hankedan000/EThrottle/doc/board_layout/README.md

# v1.0
PCB_v1.0

### Enclosure interference
version 1.0 of the board had an interference issue with the DIYPNP aluminum enclosure. I was able to grind the case to make it fit, but the issue was resolved on v1.1 by reducing the width by 1.1mm.

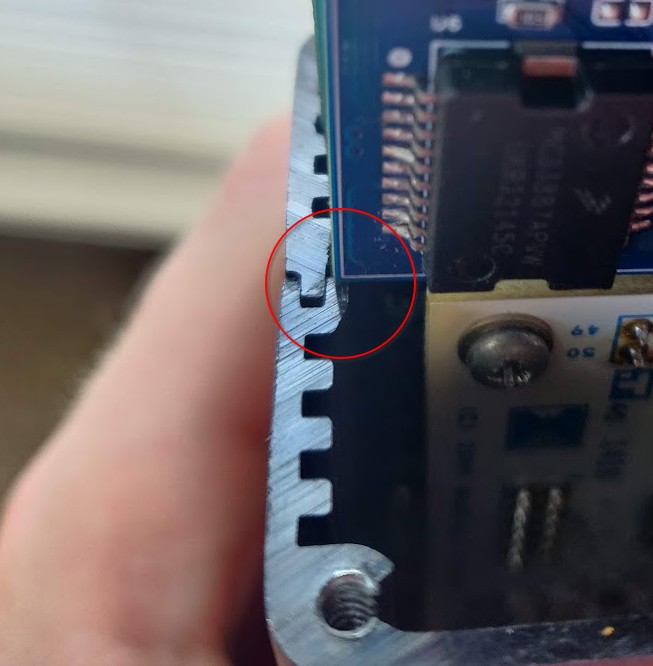
[picture p3: doc/board_layout/pcb_v1.0_case_interference.jpg]
v1.0_interference


# v1.1 (current)
NOT FINAL YET
