hankedan000/EThrottle/doc/board_layout/IMG_20220921_183644.jpg

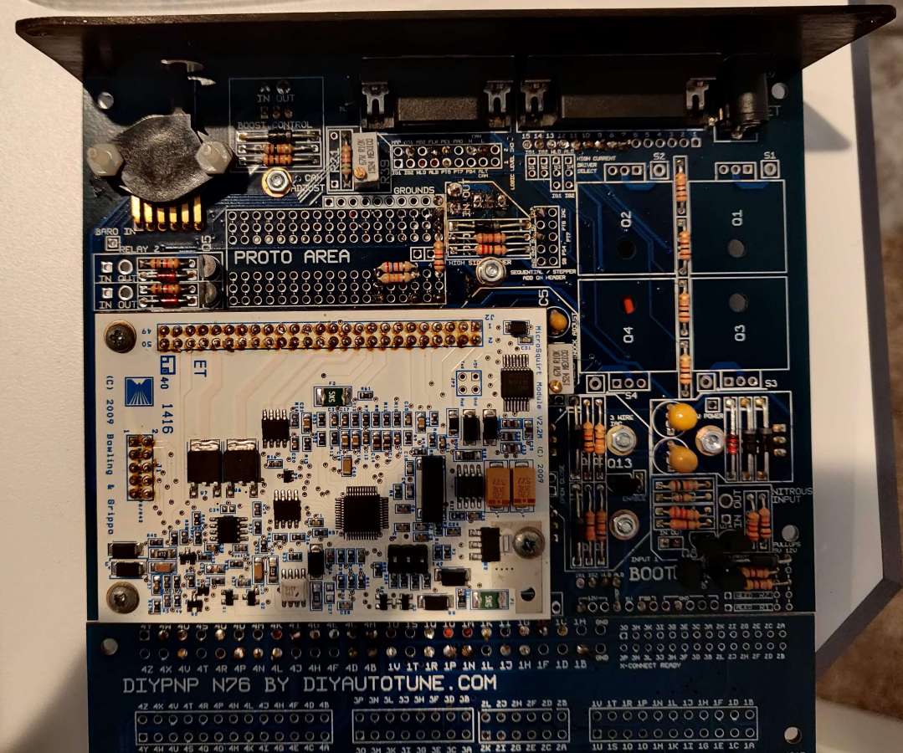
doc/board_layout/IMG_20220921_183644.jpg
