hankedan000/EThrottle/doc/wheel_speed/abs_circuit.png

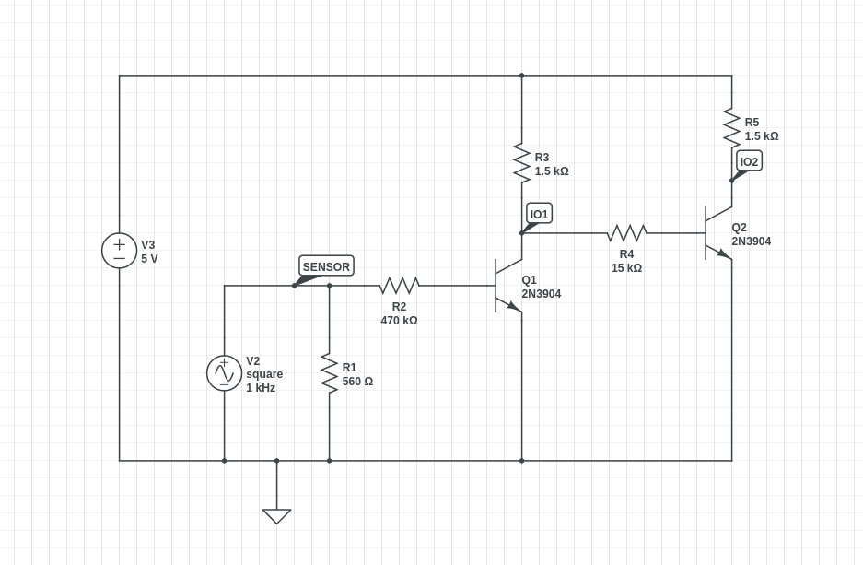
doc/wheel_speed/abs_circuit.png
