hankedan000/EThrottle/doc/wheel_speed/abs_circuit_td_sim.png

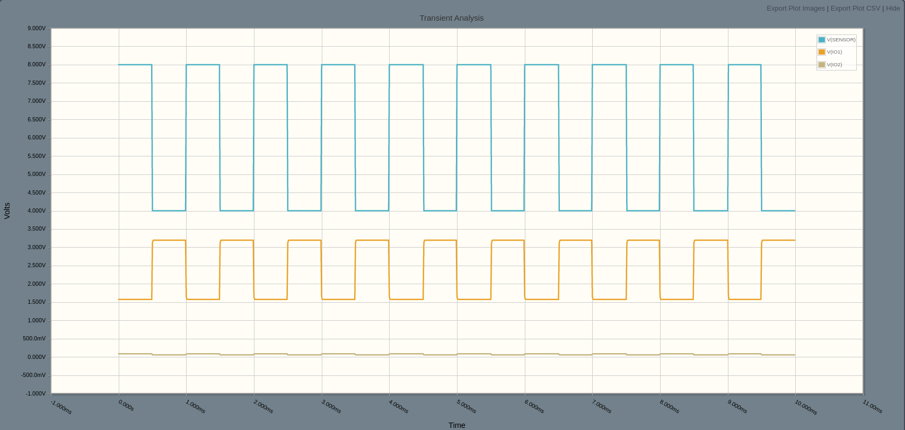
doc/wheel_speed/abs_circuit_td_sim.png
