hankedan000/EThrottle/doc/wheel_speed/abs_desktop_single_transistor.png

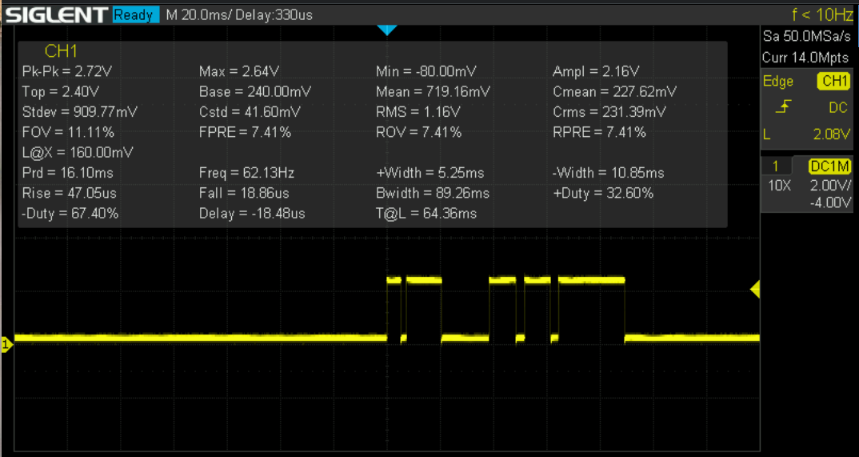
doc/wheel_speed/abs_desktop_single_transistor.png
