hankedan000/EThrottle/doc/wheel_speed/CAR_IO1.png

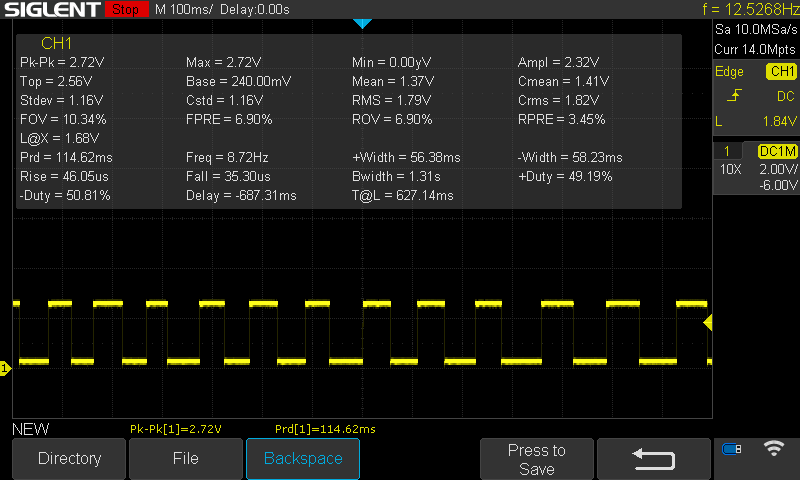
doc/wheel_speed/CAR_IO1.png
