hankedan000/EThrottle/doc/wheel_speed/CAR_IO2.png

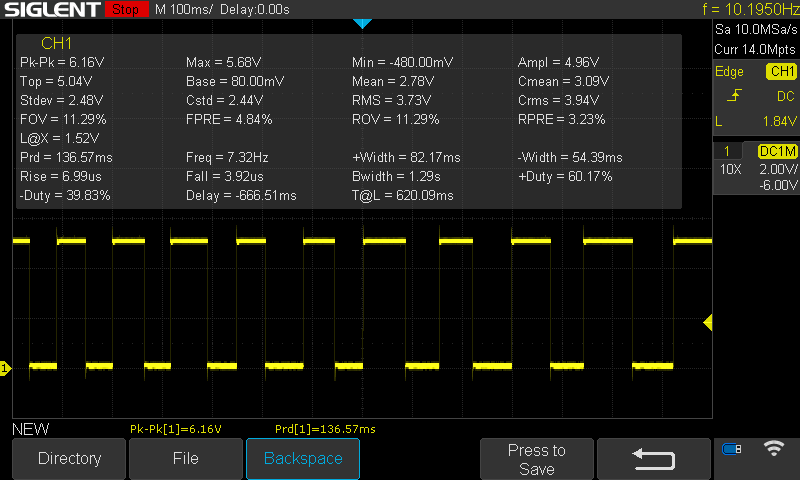
doc/wheel_speed/CAR_IO2.png
