hankedan000/EThrottle/doc/wheel_speed/CAR_SENSOR.png

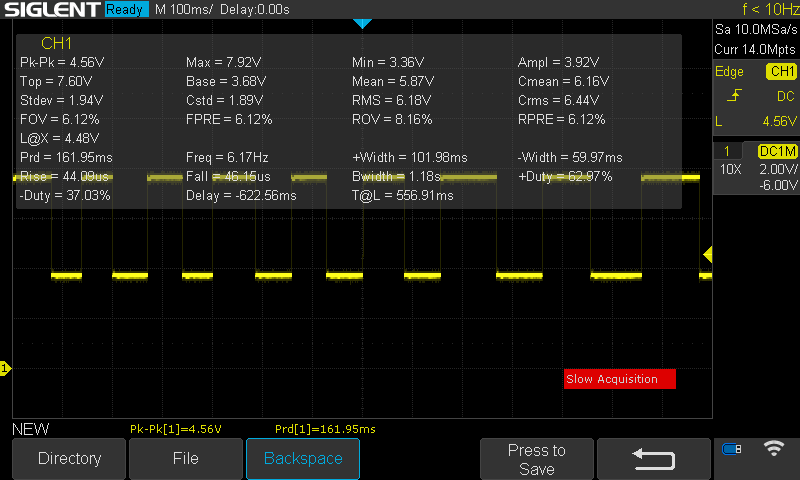
doc/wheel_speed/CAR_SENSOR.png
