hankedan000/EThrottle/(threads)

Thread 1 (2022-10-16):

How can I contact the developer?

farmdve, 2022-10-16:
As I could not find any email to contact you, I apologize for using this roundabout way.

I saw a thread of yours on swedespeed about ECU hacking, especially Denso and was wondering if you managed to extract/flash the ECU(since there was no reply on that endeavor since 2016). I am trying a similar approach but using an RPi(or even Arduino if and when such a need arises) .

Anyway, I do have some questions and if its no bother, maybe you could log back in on Swedespeed so I can ask them there?

hankedan000, 2022-10-20:
sent you an IM on swedespeed

Thread 6 (2023-04-12):

Detect/track/report motor driver fault conditions

hankedan000, 2023-04-12:
Motor the motor driver fault status pin. Keep a count of how many times the fault occurred (store in flash). Provide access to fault conditions and counter value via CAN bus.

Closed 2023-04-22.

Thread 7 (2023-04-12):

Measure/report motor current

hankedan000, 2023-04-12:
Use ADC to measure the motor current feedback pin on the MC33887. Convert that to current value (smooth/average it if needed), and then provide access to the reading via CAN bus.

Closed 2023-04-22.

Thread 10 (2023-04-13):

Setting to disable motor driver

hankedan000, 2023-04-13:
I'll need the ability to virtually disable the motor driver from the tuning laptop. This needed because I want to be able to manually actuate the throttle blade when calibrating the TPS sensor on the vehicle. If you can't disable the motor driver, then the PID algorithm will fight to keep the throttle blade where it think it should be.

In my development environment, I can easily kill power to the motor driver by disconnecting the +12V power supply to the board. This same thing can't be easily done once it's in the vehicle.

Closed 2023-04-20.

Thread 8 (2023-04-13):

Trivial Idle Control

hankedan000, 2023-04-13:
Either a minimal throttle position that can be set via CAN bus.
Eventually will need something that's coolant temperature based and/or closed loop with engine RPM.

Closed 2023-04-21.

Thread 21 (2023-04-24):

Cruise control button support

hankedan000, 2023-04-24:
Motor the cruise control buttons ADC pin and discern which buttons are pressed based on resistor ladder hardware.

Closed 2023-11-23.

Thread 22 (2023-04-24):

Clutch switch and brake switch detection

hankedan000, 2023-04-24:
We probably want these to be read in back on pin change interrupts. The interrupt will be used to disable cruise control if active.

Closed 2023-11-23.

Thread 28 (2023-04-27):

Soft reset via CAN message

hankedan000, 2023-04-27:
To utilize [this CAN-based bootloader.](https://github.com/crycode-de/mcp-can-boot), you need a way to reboot the MCU. While it is possible to just power cycle the board (it works fine, I've tested it), it would be nice if we could soft reset the MCU via a CAN message.

This issue would implement a software reset via the watchdog timer.
Here's the example code taken form the mcp-can-boot README.
```c++
#include <avr/wdt.h>   // include watchdog functions

cli();                 // disable interrupts
wdt_enable(WDTO_15MS); // watchdog timeout 15ms
while(1);              // wait for watchdog to reset mcu
```

hankedan000, 2023-06-03:
soft reset logic was added on PR #36

Closed 2023-06-03.

Thread 29 (2023-05-16):

MS3PRO

Ms3pro, 2023-05-16:
Hi! Does it work on ms3pro? Can you make a video instruction on how to connect this to a megasquirt and set up a can for communication?

I uploaded this code to arduino mega + mcp2515 and turned on ms3 pro added ini Can1 for end-to-end transmission, but I get the error there is no connection with Can1 and ms3pro remains to work alone.

hankedan000, 2023-05-17:
This code is not designed to run on an Arduino Mega (atmega2560). The code is intended to run on a regular Arduino UNO or anything with the atmega328 chip.

That being said, I don't see why the CAN passthrough functionality wouldn't work with an ms3pro because the 29bit CAN protocol is the same as the ms2.

I haven't actually got this installed in my car yet, but when I do, I might write up a setup guide or make a quick video.

Ms3pro, 2023-05-17:
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

hankedan000, 2023-05-18:
If you go to File > Project Properties, and then the "CAN Devices" tab.
Do you see the EThrottle device get detected under one of the devices like this?
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
I have my CAN ID flash with a 5, so it's showing up as device 5 in the list.
https://github.com/hankedan000/EThrottle/blob/main/src/avr/EThrottle/can.h#L8

If it's not showing up, then something must be wrong with the CAN communication. If it does show up, then maybe you just have the device setup with the wrong CAN ID (the dialog does say "A device is responding, but not at the project assigned CAN ID.")

Ms3pro, 2023-05-18:
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
Mcp2515 16mhz CAN speed 500

hankedan000, 2023-05-18:
Hmmmm you mention your MCP2515 has a 16MHz oscillator?
Most MCP2515 units I've bought off Ebay have a 8MHz oscillator. If you're is really 16MHz, then you'll need to change this constant to `MCP_16MHZ`: https://github.com/hankedan000/MegaCAN/blob/main/src/MegaCAN_Device.cpp#L99

Ms3pro, 2023-05-18:
Yes , 16mhz and I soldered this crystal myself and everything works fine on other projects with 16mhz . I 'll try to change it in the code . I removed the jumper with a knife because I was looking for a reason, now I will return the jumper to its place. I'll try again and write the results.

Ms3pro, 2023-05-18:
![Uploading IMG_20230518_230531.jpg…]()
👍

Ms3pro, 2023-05-18:
Now I see the green CAN tx indicator, but the blue id5 is not lit. I don't understand how to configure the offset and ID of the tables. Perhaps I am incorrectly specifying the offset and id in the settings.

Ms3pro, 2023-05-18:
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

Ms3pro, 2023-05-18:
https://github.com/crycode-de/mcp-can-boot
Does it need to be loaded into the arduino processor along with the throttle design?

hankedan000, 2023-05-18:
You do not need the mcp-can-boot bootloader. Although it is nice for being able to remotely flash new firmware over the CAN bus.

You do not need to enable any of the Megasquirt broadcast features that you're screenshoting for Tuner Studio to detect the CAN device.

If your CAN bus is wired correctly, and the device is functioning correctly, it should get detected and displayed in the project drop down.

At this point, you might want to put some INFO() logs in here and see if the EThrottle device is getting any CAN interrupts from messages off the bus.
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

I really think you might be hitting issues with trying to run this firmware on a chip that it wasn't intended for. I'm doing some interest stuff with timing the ADC measurements relative to the motor driver PWM signals. The code could be getting stuck in an ISR or something weird because it wasn't intended for an Atmega2560.

If you just want to try getting the CAN bus stuff working, I'd recommend commenting out the throttle related code and just let the CAN interrupts get serviced and the canLoop() called in the main loop.
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

Alternatively, if you're not interested in the EThrottle code itself, I have a much simpler GPIO CAN module example project in my MegaCAN repo (https://github.com/hankedan000/MegaCAN/tree/main/examples/GPIO). Hopefully that should run okay without having to worry the Atmega328 specific code I've developed for this project.

Ms3pro, 2023-05-21:
It turned out to connect mega 2560 GIPIO +MS3PO! Now everything works and ADC shows in the tuner studio.

Ms3pro, 2023-05-21:
![Uploading IMG_20230521_125525.jpg…]()

hankedan000, 2023-05-21:
Awesome! Glad it works out. So it was just a wiring issue the whole time?
Did you have to comment out any of the throttle code like I was suggesting?

Ms3pro, 2023-05-21:
There were problems with the 16mhz crystal, I fixed it in the code from 8mhz to 16mhz and everything works. I don't understand how to configure tables and offsets in the settings window now, I have 6 egts and it was good if ms controlled them. Now I 'll try DBW as you said .

Ms3pro, 2023-05-21:
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
The throttle code does not work, I tried to comment out these lines, but it is still undetected in the device list.

hankedan000, 2023-05-21:
Hey man. I don't know what to tell you. The code is pretty robust on my setup, but there must be something different about yours. I recommend adding debug prints in the code to see where it might be getting stuck, or just not responding. You can pretty easily add a log in the CAN ISR and see if it's receiving any of those requests you have printed. If it is getting them, them follow the code and see why it's not responding to them.

The repo is not road tested at all, so I can't make any promises for how well it works yet.

hankedan000, 2023-05-26:
i've had others report that this code can communicate with an MS3 device via can pass through. closing the issue.

Ms3pro, 2023-05-26:
Hi, your project is cool! I bought a arduino nano now everything works fine👍👏

Closed 2023-05-26.

Thread 30 (2023-05-24):

ms2exstra & ms3pro ultimate no CAN connection

andreibbmwe30, 2023-05-24:
hi! an excellent project, I put together a mock-up of arduino uno + mcp2515, but the code does not want to work, it is not detected on the network. I tried our OpenGPIO-0 project.1.0 it works fine, but E Throttle doesn't want to work online. I have a question.
1) can the code work without mc33887 in can testing?
2) maybe I'm using the wrong library and that's why the code doesn't work for me, could you download all your libraries that are used in your project?
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
 The port monitor displays the same messages!

hankedan000, 2023-05-24:
I just tested this EThrottle code on a breadboard with just an Arduino Nano + MCP2515, and nothing else. Tuner Studio was able to detect the device just fine.

There's another guy who I've been chatting with about this similar issue where Tuner Studio says it can't communicate with the device. I'm starting to think it's related to interfacing with an MS3 ECU. For my bench testing, I'm running a DIYPNP board that's running [MS2/Extra 3.4.3 release firmware](https://www.msextra.com/downloads/archive/ms2extra-archive-firmwares/). I don't have an MS3 device to work with.

I might add some code to the MegaCAN library to dump the CAN bus traffic to help rule out any bugs. Will let you know.

hankedan000, 2023-05-25:
Okay. I've pushed up a [debug-ms3-comms-issues](https://github.com/hankedan000/MegaCAN/compare/main...debug-ms3-comms-issues) to the MegaCAN repo. If you checkout that branch and set `LOG_CAN_TRAFFIC` to 1, it will dump the CAN frames to/from the device.

Here's what the initial traffic looks like for my ms2e setup. I'd be curious to see what your looks like if it's an ms3 device.
```
INFO  | BUS >>> MCU 0x00038280 | len 4 | 80 06 00 05 00 00 00 00 | ........ | // request protocol & blocking factors
INFO  | BUS <<< MCU 0x00012830 | len 5 | 02 00 20 00 20 00 00 00 | .. . ... |
INFO  | BUS >>> MCU 0x000082f8 | len 3 | 06 00 08 00 00 00 00 00 | ........ | // request signature (20 bytes)
INFO  | BUS <<< MCU 0x00012830 | len 8 | 4f 70 65 6e 47 50 49 4f | OpenGPIO | // signature bytes 0 to 7
INFO  | BUS >>> MCU 0x002082f8 | len 3 | 06 00 08 00 00 00 00 00 | ........ |
INFO  | BUS <<< MCU 0x00012830 | len 8 | 2d 31 2e 30 2e 30 20 20 | -1.0.0   | // signature bytes 8 to 15
INFO  | BUS >>> MCU 0x004082f8 | len 3 | 06 00 04 00 00 00 00 00 | ........ |
INFO  | BUS <<< MCU 0x00012830 | len 4 | 20 20 20 00 00 00 00 00 |    ..... | // signature bytes 16 to 19
INFO  | BUS >>> MCU 0x000082f0 | len 3 | 06 00 08 00 00 00 00 00 | ........ |
INFO  | BUS <<< MCU 0x00012830 | len 8 | 45 54 68 72 6f 74 74 6c | EThrottl | // request version info (60 bytes)
INFO  | BUS >>> MCU 0x002082f0 | len 3 | 06 00 08 00 00 00 00 00 | ........ |
INFO  | BUS <<< MCU 0x00012830 | len 8 | 65 00 4f 70 65 6e 47 50 | e.OpenGP | // woops!
INFO  | BUS >>> MCU 0x004082f0 | len 3 | 06 00 08 00 00 00 00 00 | ........ | // looks like my version string isn't long enough.
INFO  | BUS <<< MCU 0x00012830 | len 8 | 49 4f 2d 31 2e 30 2e 30 | IO-1.0.0 | // doesn't seem to be an issue for me on ms2e though...
INFO  | BUS >>> MCU 0x006082f0 | len 3 | 06 00 08 00 00 00 00 00 | ........ |
INFO  | BUS <<< MCU 0x00012830 | len 8 | 20 20 20 20 20 00 8e ff |      ... |
INFO  | BUS >>> MCU 0x008082f0 | len 3 | 06 00 08 00 00 00 00 00 | ........ |
INFO  | BUS <<< MCU 0x00012830 | len 8 | ff ff ff ff ff ff ff ff | ........ |
INFO  | BUS >>> MCU 0x00a082f0 | len 3 | 06 00 08 00 00 00 00 00 | ........ |
INFO  | BUS <<< MCU 0x00012830 | len 8 | ff ff ff ff ff ff ff ff | ........ |
INFO  | BUS >>> MCU 0x00c082f0 | len 3 | 06 00 08 00 00 00 00 00 | ........ |
INFO  | BUS <<< MCU 0x00012830 | len 8 | ff ff ff ff ff ff ff ff | ........ |
INFO  | BUS >>> MCU 0x00e082f0 | len 3 | 06 00 04 00 00 00 00 00 | ........ |
INFO  | BUS <<< MCU 0x00012830 | len 4 | ff ff ff ff 00 00 00 00 | ........ |
INFO  | BUS >>> MCU 0x00008288 | len 3 | 06 00 08 00 00 00 00 00 | ........ | // TS starts dumping flash tables...
INFO  | BUS <<< MCU 0x00012830 | len 8 | 00 14 00 05 00 00 ff ff | ........ |
INFO  | BUS >>> MCU 0x00208288 | len 3 | 06 00 08 00 00 00 00 00 | ........ |
INFO  | BUS <<< MCU 0x00012830 | len 8 | 00 b9 03 ff 00 21 03 c6 | .....!.. |
...
```

Notice that the traffic shows my EThrottle code sending data past the end of the version string buffer. I don't think this should be happening. I should either update the length of the version request command [here](https://github.com/hankedan000/EThrottle/blob/main/src/avr/EThrottle/EThrottle-1.0.0.ini#L20), or just specific a string of length 60bytes, so I doesn't read past the end of the string like that. Regardless, I didn't think that string mattered a whole lot. Pretty sure Tuner Studio just uses it to display in the title bar.

andreibbmwe30, 2023-05-25:
Hello!  Thank you for your answer, I used MS2/Extra 3.4.4 and MS3Pro versions MS3 pre-1.6 alpha 2, I will try to do as you said, I will let you know the result later.

andreibbmwe30, 2023-05-25:
replaced the mega can library, entered what you suggested and ms2 saw the device, but ms3 does not see it.  I connected arduino + ms2extra + ms3pro ultimate and all two devices see EThrottle, that is, if there is no ms2 in the can bus, then the can bus does not work and logging does not occur.

andreibbmwe30, 2023-05-25:
![Uploading 16849928271644736310332462189838.jpg…]()

andreibbmwe30, 2023-05-25:
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
this is if you don't run the tuner studio

andreibbmwe30, 2023-05-25:
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
this is if you run the tuner studio

andreibbmwe30, 2023-05-25:
thank you! everything works in ms3pro, I would like to add DBW support with base ids 256,257,260,261

hankedan000, 2023-05-25:
hmmm glad you seem to have gotten it working. do you mean it's now working with just the arduino + ms3pro (no ms2 on the bus)?

What do you mean support with base ids 256, 257, 260, 261? Are you referring to [receiving realtime broadcast data packets from the megasquirt](https://github.com/hankedan000/EThrottle/blob/main/src/avr/EThrottle/can.cpp#L164-L183)?

If you put up a pull request, I'd be happy to take a look. Note that I don't have an ms3pro to test with, so I can't promise to maintain any ms3pro specific features going forward.

andreibbmwe30, 2023-05-25:
that's right, everything works like this arduino + mp3pro, only you can't see it on the network until you add a CAN device and then it appears on the network

hankedan000, 2023-05-25:
Oh wow! I didn't know ms3 supported transmitting DBW control information like that. If you can code it up, and make it an optional feature (maybe with a #define toggle or something) then I can consider bringing it in.

hankedan000, 2023-05-26:
CAN pass through communication is functioning on MS2 and MS3 devices. Issue appears to be that the *.ini file was not loaded into the TunerStudio project.

andreibbmwe30, 2023-05-26:
I have a piece of code for DBW, how can I add it to your project

andreibbmwe30, 2023-05-26:
#include <SPI.h>
#include <mcp2515.h>

struct can_frame canMsg;
MCP2515 mcp2515(53);

int TPS;
int sensor01=A1;
int s1, a, b;
int sensor02=A2;
int s2, e, f;

unsigned int textCounter = 0;

long unsigned int rxId;
unsigned char len = 0;
unsigned char rxBuf[8];
char msgString[128];

void setup()
{
SPI.begin();
mcp2515.reset();
mcp2515.setBitrate(CAN_500KBPS, MCP_16MHZ);
mcp2515.setNormalMode();
}
void loop()
{
if (mcp2515.readMessage(&canMsg) == MCP2515::ERROR_OK) {
for (int i = 0; i<canMsg.can_dlc; i++)   {
}
}
switch (canMsg.can_id) {
case 260:                          // read servo position map from ms3
TPS = (float)(word(canMsg.data[0], canMsg.data[1])); TPS = (TPS / 10); //????
break;
}
  s1=analogRead(sensor01); //ПОЛОЖЕНИЕ PEDAL
  b=s1;               //ПОЛОЖЕНИЕ PEDAL
  s2=analogRead(sensor02); //ПОЛОЖЕНИЕ THROTTLE
  f=s2;               //ПОЛОЖЕНИЕ THROTTLE
  canMsg.can_id  = 0x100;   //MS DBW ID256
  canMsg.can_dlc = 8;       
  canMsg.data[0]= s1 >> 8;  //ПОЛОЖЕНИЕ PEDAL     
  canMsg.data[1] = b& 0xff;         //ПОЛОЖЕНИЕ PEDAL
  canMsg.data[2] = s2 >> 8; //ПОЛОЖЕНИЕ THROTTLE    
  canMsg.data[3] = f & 0xff;         //ПОЛОЖЕНИЕ THROTTLE
  canMsg.data[4] = 0x00;
  canMsg.data[5] = 0x00;
  canMsg.data[6] = 0x00;
  canMsg.data[7] = 0x00;
  mcp2515.sendMessage(&canMsg);
 delay(20);
 }

Closed 2023-05-26.

Thread 34 (2023-05-31):

How do I add my messages to the CAN of your code EThrottle  ?

Ms3pro, 2023-05-31:
#include <SPI.h>
#include <mcp2515.h>

struct can_frame canMsg;
MCP2515 mcp2515(10);//CS
                  //INT3-2

int TrottleTarged; //MS3PRO DBW TABLE TARGET ID260 - 0X104

int sensor01=A1;//PEDAL POSITION 0-1023
int s1, a, b;   //PEDAL POSITION 0-1023
int sensor02=A2;//THROTTLE POSITION 0-1023
int s2, e, f;   //THROTTLE POSITION 0-1023

unsigned int textCounter = 0;

long unsigned int rxId;
unsigned char len = 0;
unsigned char rxBuf[8];
char msgString[128];

void setup()
{
SPI.begin();
 Serial.begin(115200);
pinMode(5 , OUTPUT);

mcp2515.reset();
mcp2515.setBitrate(CAN_500KBPS, MCP_8MHZ);
mcp2515.setNormalMode();
}

void loop()
{
  TrottleTarged = map(TrottleTarged,0 , 1023, 0, 255);     // scale it to use it with the servo (value between 0 and 180)
  analogWrite(5,TrottleTarged);
               // sets the servo position according to the scaled value

if (mcp2515.readMessage(&canMsg) == MCP2515::ERROR_OK) {
for (int i = 0; i<canMsg.can_dlc; i++)   {
}
}
switch (canMsg.can_id) {
case 260:                          // read servo position map from ms3 //MS3PRO DBW TABLE TARGET ID260 - 0X104

TrottleTarged = (float)(word(canMsg.data[0], canMsg.data[1]));
break;
}
  s1=analogRead(sensor01);  //PEDAL POSITION 0-1023
  b=s1;                     //PEDAL POSITION 0-1023
  s2=analogRead(sensor02);  //THROTTLE POSITION 0-1023
  f=s2;                     //THROTTLE POSITION 0-1023
  canMsg.can_id  = 0x100;   //ARDUINO SEND TO MS DBW ID256
  canMsg.can_dlc = 8;       
  canMsg.data[0]= s1 >> 8;  //PEDAL POSITION 0-1023    
  canMsg.data[1] = b& 0xff; //PEDAL POSITION 0-1023
  canMsg.data[2] = s2 >> 8; //THROTTLE POSITION 0-1023  
  canMsg.data[3] = f & 0xff;//THROTTLE POSITION 0-1023
  canMsg.data[4] = 0x00;
  canMsg.data[5] = 0x00;
  canMsg.data[6] = 0x00;
  canMsg.data[7] = 0x00;
  mcp2515.sendMessage(&canMsg);
 delay(20);

int DBW = digitalRead(5);

 Serial.println(TrottleTarged);
 Serial.println(DBW);
 }
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
Hi! I have a little code to test, and it works fine with ms3pro, except for the PWM output. Someone has already written to you with the same request. Could you create a separate branch with ( beta code EThrottle  for ms3pro) ?

Is it possible to see at least one example of building an 11-bit frame for receiving from MS and sending to MS on id256, id260? I just don't understand Megacan, but I only understand the mcp_can or mcp2515 libraries, and only based on these libraries I can create a frame, receive or send, but not Megacan.
I would love to test this on my ms3pro thank you!

Ms3pro, 2023-05-31:
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

I would love to test this on my ms3pro thank you!

Ms3pro, 2023-07-11:
Hi! I can send and receive mstarget in ms PPS TPS, but I need to test a little later when there is time. Here 's what has changed in the code . Now the ms can control the flap through the CAN with the addition of the base id 260 and the variable mstarget.

#include <EEPROM.h>
#include <avr/sfr_defs.h>
#include <avr/wdt.h>
#include <string.h>
#include <stdlib.h>
#include "stdint.h"
#include "adc_ctrl.h"
#include "can.h"
#include "config.h"
#include "EndianUtils.h"
#include <logging.h>
#include "Throttle.h"
#include "uart.h"
///////////////////////////////////////////////////////////////////////////////////
//#include "FlashUtils.h"
//#include "MegaCAN_ExtDevice.h"
//#include "MegaCAN_RT_BroadcastHelper.h"
//#include "tables.h"
#include <TaskScheduler.h>
////////////////////////////////////////////////////////////////////////////////////
// analog inputs
#define CTRL_BUTN A4

// digital outputs
#define WSPEED_INT 2
                // 3 CAN interrupt
#define CLUTCH_SW  8
#define BRAKE_SW   9
                // 10 CAN CS
                // 11 CAN MOSI
                // 12 CAN MISO
                // 13 CAN SCK

#define RT_BCAST_OFFSET PAGE2_FIELD_OFFSET(rtBcast)
Throttle::OutVars *throttleVars = &outPC.throttleOutVars;

Scheduler ts;

// setup watchdog
void wdtInit() {
  cli();// disable interrupts
  wdt_reset();// reset watchdog
  wdt_enable(WDTO_15MS);// start watchdog timer with 15ms timeout
  sei();
}
//////////////////////////////////////////////////////////////////////////////////////////////////////////
void canISR();

void send_rt_bcast_group()
{
  uint16_t id = 0x100;

      uint16_t ppsValue = throttleVars->pps;  // Получение значения переменной pps
      uint16_t tpsValue = throttleVars->tps;  // Получение значения переменной tps
      uint8_t data[8];

      // Заполнение данных в массиве байтов в порядке Big-Endian
      data[0] = (ppsValue >> 8) & 0xFF;  // Старший байт ppsValue
      data[1] = ppsValue & 0xFF;         // Младший байт ppsValue
      data[2] = (tpsValue >> 8) & 0xFF;  // Старший байт tpsValue
      data[3] = tpsValue & 0xFF;         // Младший байт tpsValue
      data[4] = 0x00;
      data[5] = 0x00;
      data[6] = 0x00;
      data[7] = 0x00;

      canDev.send11bitFrame(id, 8, data);  // Отправка сообщения CAN с идентификатором и данными

}
////////////////////////////////////////////////////////////////////////////////////////////////////////////
void setup() {

#ifdef MCP_CAN_BOOT_BL
  // retrieves the MCU reset cause (MCUSR register) when using the
  // mcp-can-boot bootloader (https://github.com/crycode-de/mcp-can-boot).
  uint8_t mcusr;
  __asm__ __volatile__ ( "mov %0, r2 \n" : "=r" (mcusr) : );
#endif

#if WATCHDOG_SUPPORT
  wdtInit();// start watchdog
#endif

  setupLogging(115200);

  INFO("WATCHDOG: %s", (WATCHDOG_SUPPORT ? "ON" : "OFF"));
#ifdef MCP_CAN_BOOT_BL
  outPC.mcusr = mcusr;
  INFO("MCUSR: 0x%x", mcusr);
#else
  outPC.mcusr = 0;// arduino bootloader doesn't preserve MCUSR contents
#endif

  throttle.init(PID_SAMPLE_RATE_MS, throttleVars);
  loadThrottlePID_FromFlash(throttle);
  loadSensorCalibrationsFromFlash(throttle);
  loadSensorSetupFromFlash(throttle);

  canSetup();
MegaCAN::RT_Bcast.setup(&ts, RT_BCAST_OFFSET, send_rt_bcast_group);
  if ( ! adc::start())
  {
    WARN("no ADC measurements enabled");
  }
}

void loop() {
  wdt_reset();// throw watchdog a bone
  uint32_t loopStartTimeUs = micros();
ts.execute();
 MegaCAN::RT_Bcast.execute();
  doUart();
  canLoop();
  throttle.run();

  // update loop time register
  uint16_t loopTimeUs = micros() - loopStartTimeUs;
  EndianUtils::setBE(outPC.loopTimeUs, loopTimeUs);

}

Ms3pro, 2023-07-11:
Throttle.h

// don't let tps target go below the stall point
    tpsTarget_ = ecu::mstarget;

    pidSetpoint_ = tpsTarget_;
    pidIn_ = tps_;
    newCycle = pid_.Compute();

    DEBUG("pidIn_: %f", pidIn_);

Ms3pro, 2023-07-11:
// filter Megasquirt broadcast frames into RXB1
  can->init_Mask(1,ID_TYPE_STD,0x104);
  can->init_Filt(2,ID_TYPE_STD,0x00000000);
  can->init_Filt(3,ID_TYPE_STD,0x00000000);
  can->init_Filt(4,ID_TYPE_STD,0x00000000);
  can->init_Filt(5,ID_TYPE_STD,0x00000000);

Ms3pro, 2023-07-11:
switch (msgId)
  {
    case 0://0
    {
      ecu::mstarget = MSG00_t::get_mstarget(data);

      DEBUG(
          "mstarget = %d",
          MSG00_t::get_mstarget(data),
          ecu::mstarget);
      break;
    }
      case 1://0
    {
      ecu::rpm = MSG1260_t::get_rpm(data);

      DEBUG(
          "rpm = %d",
          MSG1260_t::get_rpm(data),
          MSG1260_t::get_pw1(data),
          MSG1260_t::get_pw2(data),
          ecu::rpm);
      break;

Closed 2023-09-21.

Thread 39 (2023-09-21):

Compilation error #2

Sando757, 2023-09-21:
Thanks for updating the code, it helped me move forward. But again there was a compiler error, as I understand it, the problem is that the <logging_impl.h> library is not connected.

https://i.ibb.co/R2gLTgp/Screenshot-4.png

And one more problem in the archive there are no files: arduino-pid-autotuner, megaCAN and some others, I would like to help collect a complete archive to make it easier for people to start a project. If I could somehow contact you, I would send you the complete package.

hankedan000, 2023-09-21:
This is another issue with you not using the correct version of one of my libraries. In this case, I made an update in my logging library that broke compatibility. Sorry, I'm still learning how best to structure arduino libraries and projects.

I put up a branch that switches over to using submodules for all the library dependencies. Pull request #41 is open now. If you check out the submodules branch, and follow the new instructions in the README, I think it will hopefully resolve your library dependency issues.

Sando757, 2023-09-22:
It looks better. But it can still cause difficulties for some people. If possible, it would be a good idea to add a compiled ".hex" file to the archive so that it can be loaded via "Xloader", for example. This would eliminate any mistakes.

Closed 2023-10-21.

Thread 40 (2023-09-21):

Throttle body fluctuations

Sando757, 2023-09-21:
I was able to compile the firmware and load it onto the V1.1 module, connected via the CAN bus to the Megasquirt 2 board (3.4.4) - everything works. But there is a permanent driver error. The throttle body fluctuates ~5% regardless of PID settings. The motoroutPWM and current also have strong fluctuations. Tried it on 2 different boards. I don’t know what this is connected with, but perhaps these symptoms will help understand the problem.

https://i.ibb.co/XLSfbJH/Screenshot-5.png
The screenshot shows the fluctuations, in reality they are very strong.
Perhaps I can help with something, I have megasquirt 2, megasquirt 3x and megasquirt board simulator and 5pcs psb v1.1.

hankedan000, 2023-09-22:
I'm actually struggling with jitter/stability issues myself. I think my circuit design is lacking filtering on the ADC lines. In my case, I have about a 6ft length of wires running to the throttle body, and I think there's noise coupling onto the TPS ADC wires. I've actually had the noise get so bad, that it's fried the arduino chip. I'm really struggling to resolve these issues. I've tried oscoping the lines, and I never see super high voltage spikes occur, but something is terribly wrong.

I implemented [software filtering](https://github.com/hankedan000/EThrottle/commit/49e2dc2cb0c6f079b5d8ce2d7d4c9b3abcc0ad7c) of the ADC lines, to help reduce the jitter, but it doesn't prevent the chips from eventually frying :(

Sando757, 2023-09-22:
As far as I can see, the Arduino burns out due to surges on the +12 line (VIN) from motor. There is also low-quality LM1117 stabilizer, I separated the +5 and +12 power lines, added power supply capacitors (25V 220U for both lines) and nothing else burned out. It would also be a good idea to add suppressors (SMBJ15-17) on the power lines.

About oscillations, I added filter circuits (RC), they reduced the interference in the program (graph in the PID settings), but still the throttle body has fluctuations (much less).

According to my observations, the value of motorOUTPWM changes too quickly and greatly, and there is also a rapid fluctuation of targettps + -0.5%. But I don’t know how to fix this, since I don’t understand programming well.

Thread 42 (2023-10-14):

Coms with MS

ateixeira07061992, 2023-10-14:
So I have all the hardware set up, but I'm failing to understand how MS receives the TPS sensor.. do we need to use one of the sensors from  the ETB?
Also, I'm I bit confused with the configuration
I sniffed the can coms and can only see MS broadcasting (when set to do so) and stuff related to passthrough coms not the signals from the module..
Btw, its also for a Miata :)
here ismy contact if youre willing to talk that way i would apreciate.
ateixeira07061992@gmail.com

Thread 43 (2024-11-28):

Help Needed with Custom Bootloader and Code Upload Issue

saidsamet, 2024-11-28:
I successfully burned the bootloader using an Arduino Mega as ISP. However, when I try to upload sketches via the Arduino IDE, I receive the following error:

avrdude: stk500_recv(): programmer is not responding

Could you assist me in diagnosing and resolving this issue? You can reach me at qaftravels@gmail.com

Thank you for your support!

hankedan000, 2024-11-28:
When you say custom bootloader, are you talking about https://github.com/crycode-de/mcp-can-boot?

If so, that loader only supports CAN programming and not via USB/UART.

saidsamet, 2024-11-29:
yes, I use MCP can boot. Do you mean I have to compile the program and upload it to Arduino nano, and the change the bootloader via Arduino as ISP?

hankedan000, 2024-11-29:
No, I mean the MCP can boot bootloader doesn't support programming via the USB/UART cable. It only supports uploading programs via the can bus. To program via the USB, you'll need to put the stock Arduino bootloader back on (or use Optiboot or something else).

To flash via can bus, I use this USB to can bus adapter https://www.ebay.com/itm/404496944235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. I export the Arduino sketch to a binary file via the Arduino IDE, and then program it with the command line tool that crycode-de developed.
