hankedan000/EThrottle/(list of files, drawings)

Other design files:
src/pcb/msq_ethrottle_soic.eprj
