hankedan000/EThrottle/src/arduino/EThrottle/Throttle.cpp

#include "Throttle.h"

#include <Arduino.h>
#include <logging.h>

#include "adc_ctrl.h"
#include <EndianUtils.h>
#include <FlashUtils.h>

#define ST_FAULT_TIMEOUT_MAX 10
#define LT_FAULT_TIMEOUT_MAX 100
#define LT_FAULT_THRESH 5

// toggle a pin on different fault conditions
#define ENABLE_ETHROTTLE_STROBES  0 // global enable
#define STROBE_PIN A4
#define STROBE_ON_TPS_FAULT 1
#define STROBE_ON_PPS_FAULT 0

Throttle throttle(
  DRIVER_P,DRIVER_N,
  DRIVER_DIS,
  DRIVER_FS);

Throttle::Throttle(
    uint8_t driverPinP,
    uint8_t driverPinN,
    uint8_t driverPinDis,
    uint8_t driverPinFS)
 : driverPinP_(driverPinP)
 , driverPinN_(driverPinN)
 , driverPinDis_(driverPinDis)
 , driverPinFS_(driverPinFS)
 , tpsTarget_(0)
 , tpsStall_(0)
 , idleAdder_(0)
 , ppsAdder_(0)
 , motorOut_(0)
 , outVars_(nullptr)
 , pidSampleRate_ms_(100)
 , pid_(&pidIn_,&pidOut_,&pidSetpoint_,0,0,0, DIRECT)
 , setpointSource_(SetpointSource_E::eSS_PPS)
 , userSetpoint_(0)
 , sensorSetup_()
 , ppsCompareThresh_(50)
 , tpsCompareThresh_(50)
{
  // setup ADC measurements
  adc::tpsA.adcMUX = 0;// A0
  adc::tpsA.mMode = adc::MeasurementMode_E::eMM_Continuous;
  adc::tpsB.adcMUX = 1;// A1
  adc::tpsB.mMode = adc::MeasurementMode_E::eMM_Continuous;
  adc::ppsA.adcMUX = 2;// A2
  adc::ppsA.mMode = adc::MeasurementMode_E::eMM_Continuous;
  adc::ppsB.adcMUX = 3;// A3
  adc::ppsB.mMode = adc::MeasurementMode_E::eMM_Continuous;
  adc::driverFB.adcMUX = 5;// A5
  adc::driverFB.mMode = adc::MeasurementMode_E::eMM_OneShot;
  // Rationale for triggering current feedback off timer0 overflow:
  //
  // The motor pins are driven by PD6 (OC0A) and PD5 (OC0B).
  // Those pins are driven by the timer0 PWM logic.
  // Here's the timer 0 config set by Arduino's wiring library.
  // TCCR0A: 0x83
  // TCCR0B: 0x03
  //   WGM   -> 0x011 (Fast PWM mode)
  //   COM0A -> 0b10 (clear OCA on compare match, set OCA at BOTTOM)
  //   COM0B -> 0b10 (clear OCB on compare match, set OCB at BOTTOM)
  //   CS    -> 0b011 (Clk_io / 64)
  // Motor driver measurements must we precisely taken when the PWM
  // outputs are being driven high; otherwise, the readings are too
  // random. Since both PWM outputs are driven high when timer0 hits
  // BOTTOM (ie. overflows), we can auto trigger the current feedback
  // ADC measurement off of the timer0 overflow event.
  adc::driverFB.tMode = adc::TriggerMode_E::eTM_Tmr0_Ovrf;

  status_.pidAutoTuneBusy = 0;
  status_.ppsComparisonFault = 0;
  status_.tpsComparisonFault = 0;
  status_.throttleEnabled = 0;
  status_.motorEnabled = 0;
  status_.motorDriverFault = 0;
  status_.adcStalled = 0;

  // zero out coefficients to be safe
  updatePID_Coeffs(0.0,0.0,0.0);

  // defaults. these can get changed via setSensorSetup()
  sensorSetup_.comparePPS = 0;
  sensorSetup_.preferPPS_A = 1;
  sensorSetup_.compareTPS = 0;
  sensorSetup_.preferTPS_A = 0;
}

void
Throttle::init(
    uint8_t pidSampleRate_ms,
    OutVars *outVars)
{
  pidSampleRate_ms_ = pidSampleRate_ms;
  outVars_ = outVars;

  pinMode(driverPinP_, OUTPUT);
  pinMode(driverPinN_, OUTPUT);
  pinMode(driverPinDis_, OUTPUT);
  pinMode(driverPinFS_, INPUT_PULLUP);
#if ENABLE_ETHROTTLE_STROBES
    pinMode(STROBE_PIN, OUTPUT);
#endif

  enableThrottle();
  analogWrite(driverPinP_,0);
  analogWrite(driverPinN_,0);

  // setup the PID controller class
  pid_.SetMode(AUTOMATIC);
#ifdef SUPPORT_H_BRIDGE
  // negative range is used to reverse motor to close throttle
  pid_.SetOutputLimits(-255, 255);
  tuner_.setOutputRange(-255, 255);
#else
  pid_.SetOutputLimits(0, 255);
  tuner_.setOutputRange(0, 255);
#endif

  pid_.SetSampleTime(pidSampleRate_ms_);
  tuner_.setZNMode(PIDAutotuner::ZNModeNoOvershoot);
  tuner_.setLoopInterval(pidSampleRate_ms_ * 1000);
}

void
Throttle::disableThrottle()
{
  status_.throttleEnabled = 0;
  disableMotor();
}

void
Throttle::enableThrottle()
{
  status_.throttleEnabled = 1;
  enableMotor();
}

void
Throttle::setSetpointSource(
  SetpointSource_E source)
{
  setpointSource_ = source;
}

Throttle::SetpointSource_E
Throttle::getSetpointSource() const
{
  return setpointSource_;
}

void
Throttle::setRangeCalPPS_A(
  Throttle::RangeCalibration rc)
{
  ppsCalA_ = rc;
}

void
Throttle::setRangeCalPPS_B(
  Throttle::RangeCalibration rc)
{
  ppsCalB_ = rc;
}

void
Throttle::setRangeCalTPS_A(
  Throttle::RangeCalibration rc)
{
  tpsCalA_ = rc;
}

void
Throttle::setRangeCalTPS_B(
  Throttle::RangeCalibration rc)
{
  tpsCalB_ = rc;
}

void
Throttle::setSensorSetup(
  Throttle::SensorSetup setup,
  const FlashTableDescriptor &ppsCompDesc,
  const FlashTableDescriptor &tpsCompDesc,
  uint16_t ppsCompareThresh,
  uint16_t tpsCompareThresh,
  uint16_t tpsStall)
{
  sensorSetup_ = setup;
  ppsCompDesc_ = ppsCompDesc;
  tpsCompDesc_ = tpsCompDesc;
  ppsCompareThresh_ = ppsCompareThresh;
  tpsCompareThresh_ = tpsCompareThresh;
  tpsStall_ = tpsStall;
}

void
Throttle::setSetpointOverride(
  double value)
{
  if (setpointSource_ == SetpointSource_E::eSS_User)
  {
    if (value >= 0.0 && value <= 100.0)
    {
      userSetpoint_ = value * 100.0;
    }
  }
}

const Throttle::Status &
Throttle::status() const
{
  return status_;
}

void
Throttle::clearFault(
  Throttle::FaultClearCmd_E cmd)
{
  const bool clrAll = cmd == FaultClearCmd_E::eFCC_All;

  if (clrAll || cmd == FaultClearCmd_E::eFCC_PPS)
  {
    status_.ppsComparisonFault = 0;
    ppsFaultFilter_.reset();
  }
  if (clrAll || cmd == FaultClearCmd_E::eFCC_TPS)
  {
    status_.tpsComparisonFault = 0;
    tpsFaultFilter_.reset();
  }
  if ((clrAll || cmd == FaultClearCmd_E::eFCC_Driver) && status_.motorDriverFault)
  {
    // MC33887 fault status is sticky
    // need to disable/enable motor to clear
    disableMotor();
    enableMotor();
    status_.motorDriverFault = 0;
  }
}

void
Throttle::run()
{
  doPedal();
  doThrottle();
  doMotorCurrent();

  DEBUG("driverFB: %4d; motorCurrent: %4d mA", driverFB_, motorCurrent_mA_);

  if (outVars_)
  {
    EndianUtils::setBE(outVars_->tpsA, tpsA_);
    EndianUtils::setBE(outVars_->tpsB, tpsB_);
    EndianUtils::setBE(outVars_->tps, tps_);
    EndianUtils::setBE(outVars_->ppsA, ppsA_);
    EndianUtils::setBE(outVars_->ppsB, ppsB_);
    EndianUtils::setBE(outVars_->pps, pps_);
    EndianUtils::setBE(outVars_->tpsTarget, tpsTarget_);
    EndianUtils::setBE(outVars_->motorOut, motorOut_);
    EndianUtils::setBE(outVars_->motorCurrent_mA, motorCurrent_mA_);
    outVars_->status = status_;
    EndianUtils::setBE(outVars_->idleAdder, idleAdder_);
    EndianUtils::setBE(outVars_->ppsAdder, ppsAdder_);
    EndianUtils::setBE(outVars_->driverFB, driverFB_);
  }
}

void
Throttle::updatePID_Coeffs(
  double Kp,
  double Ki,
  double Kd)
{
  pid_.SetTunings(Kp,Ki,Kd);
}

double
Throttle::getKp()
{
  return pid_.GetKp();
}

double
Throttle::getKi()
{
  return pid_.GetKi();
}

double
Throttle::getKd()
{
  return pid_.GetKd();
}

void
Throttle::startPID_AutoTune()
{
  if (status_.pidAutoTuneBusy) {
    return;
  }

  const uint16_t AUTOTUNE_TARGET = 5000;// 50%

  status_.pidAutoTuneBusy = 1;
  tuner_.setTargetInputValue(AUTOTUNE_TARGET);
  tuner_.startTuningLoop(micros());
}

void
Throttle::stopPID_AutoTune()
{
  status_.pidAutoTuneBusy = 0;
}

void
Throttle::disableMotor()
{
  digitalWrite(driverPinDis_, 1);
  status_.motorEnabled = 0;
}

void
Throttle::enableMotor()
{
  if (status_.throttleEnabled)
  {
    digitalWrite(driverPinDis_, 0);
    status_.motorEnabled = 1;
  }
}

void
Throttle::doPedal()
{
  ppsA_ = adc::ppsA.value;
  ppsB_ = adc::ppsB.value;

  // normalize PPS readings based on calibrated min/max values
  const int16_t ppsA_Norm = map(ppsA_, ppsCalA_.min, ppsCalA_.max, 0, 10000);
  const int16_t ppsB_Norm = map(ppsB_, ppsCalB_.min, ppsCalB_.max, 0, 10000);

  DEBUG("ppsA: %d, ppsB: %d", ppsA_, ppsB_);
  DEBUG("ppsA_Norm: %d, ppsB_Norm: %d", ppsA_Norm, ppsB_Norm);

  // safety check the raw ADC values
  if (sensorSetup_.comparePPS)
  {
    const int16_t preferADC = (sensorSetup_.preferPPS_A ? ppsA_ : ppsB_);
    const int16_t otherADC = (sensorSetup_.preferPPS_A ? ppsB_ : ppsA_);

    // lookup what we expect the other sensor's ADC value to be based
    // on the prefered sensor's reading.
    const int16_t otherExpected = FlashUtils::lerpS16(
      ppsCompDesc_.xBinsFlashOffset,
      ppsCompDesc_.yBinsFlashOffset,
      ppsCompDesc_.nBins,
      preferADC);
    const int16_t ppsDelta = otherADC - otherExpected;
    EndianUtils::setBE(outVars_->ppsSafetyDelta, ppsDelta);
    DEBUG(
      "preferADC = %d, otherADC = %d, otherExpected = %d, ppsDelta = %d",
      preferADC,
      otherADC,
      otherExpected,
      ppsDelta);

    // fault filtering logic
    const bool faulted = abs(ppsDelta) >= ppsCompareThresh_;
#if ENABLE_ETHROTTLE_STROBES && STROBE_ON_PPS_FAULT
      digitalWrite(STROBE_PIN, faulted);
      digitalWrite(STROBE_PIN, 0);
#endif
    outVars_->ppsCompFaultCount += faulted;
    const ModeWithTransition mwt = ppsFaultFilter_.process(faulted);
    if (mwt.mode == FaultMode_E::eFM_LongTerm)
    {
      pps_ = 0;// default to 0% pedal position to be safe
      status_.ppsComparisonFault = 1;
    }
    else if (mwt.mode == FaultMode_E::eFM_Nominal)
    {
      status_.ppsComparisonFault = 0;
    }
  }

  // compute final pps values based on optional fault filtering logic
  // Note: short term fault will preserve previous good PPS value
  if (status_.ppsComparisonFault == 0)
  {
    // Compute PPS percentage based on prefered sensor's normalized
    // percentage. The tuner should set the prefered sensor (A or B)
    // based on which one gives readings over the full range of the
    // accelerator pedal.
    // Note: pps_ can get set to 0% if PPS safety checks fail.
    pps_ = (sensorSetup_.preferPPS_A ? ppsA_Norm : ppsB_Norm);
    if (pps_ < 0) {
      pps_ = 0;
    } else if (pps_ > 10000) {
      pps_ = 10000;
    }
  }

  DEBUG("pps_: %d", pps_);
}

void
Throttle::doThrottle()
{
  tpsA_ = adc::tpsA.value;
  tpsB_ = adc::tpsB.value;

  // normalize TPS readings based on calibrated min/max values
  const int16_t tpsA_Norm = map(tpsA_, tpsCalA_.min, tpsCalA_.max, 0, 10000);
  const int16_t tpsB_Norm = map(tpsB_, tpsCalB_.min, tpsCalB_.max, 0, 10000);
  DEBUG("tpsA: %d, tpsB: %d", tpsA_Norm, tpsB_Norm);

  // safety check the raw ADC values
  if (sensorSetup_.compareTPS)
  {
    const int16_t preferADC = (sensorSetup_.preferTPS_A ? tpsA_ : tpsB_);
    const int16_t otherADC = (sensorSetup_.preferTPS_A ? tpsB_ : tpsA_);

    // lookup what we expect the other sensor's ADC value to be based
    // on the prefered sensor's reading.
    const int16_t otherExpected = FlashUtils::lerpS16(
      tpsCompDesc_.xBinsFlashOffset,
      tpsCompDesc_.yBinsFlashOffset,
      tpsCompDesc_.nBins,
      preferADC);
    const int16_t tpsDelta = otherADC - otherExpected;
    EndianUtils::setBE(outVars_->tpsSafetyDelta, tpsDelta);
    DEBUG(
      "preferADC = %d, otherADC = %d, otherExpected = %d, tpsDelta = %d",
      preferADC,
      otherADC,
      otherExpected,
      tpsDelta);

    // fault filtering logic
    const bool faulted = abs(tpsDelta) >= tpsCompareThresh_;
#if ENABLE_ETHROTTLE_STROBES && STROBE_ON_TPS_FAULT
      digitalWrite(STROBE_PIN, faulted);
      digitalWrite(STROBE_PIN, 0);
#endif
    outVars_->tpsCompFaultCount += faulted;
    const ModeWithTransition mwt = tpsFaultFilter_.process(faulted);
    if (mwt.mode == FaultMode_E::eFM_LongTerm)
    {
      disableMotor();
      status_.tpsComparisonFault = 1;
    }
    else if (mwt.mode == FaultMode_E::eFM_Nominal && mwt.transition)
    {
      enableMotor();
      status_.tpsComparisonFault = 0;
    }
  }

  // compute final tps values based on if we're within fault
  // Note: short term fault will preserve previous good TPS value
  if (status_.tpsComparisonFault == 0)
  {
    // Compute TPS percentage based on prefered sensor's normalized
    // percentage. The tuner should set the prefered sensor (A or B)
    // based on which one gives readings over the full range of the
    // throttle blade.
    // Note: tps_ can get set to 0% if TPS safety checks fail.
    tps_ = (sensorSetup_.preferTPS_A ? tpsA_Norm : tpsB_Norm);
  }

  // update PID controller
  bool newCycle = 0;
  if (status_.throttleEnabled)
  {
    switch (setpointSource_)
    {
      case SetpointSource_E::eSS_PPS:
      {
        ppsAdder_ = ((int32_t)(10000 - tpsStall_ - idleAdder_) * pps_) / 10000;
        tpsTarget_ = tpsStall_ + idleAdder_ + ppsAdder_;
        break;
      }
      case SetpointSource_E::eSS_User:
        tpsTarget_ = userSetpoint_;
        break;
    }

    // don't let tps target go below the stall point
    tpsTarget_ = max(tpsStall_, tpsTarget_);

    pidSetpoint_ = tpsTarget_;  
    pidIn_ = tps_;
    newCycle = pid_.Compute();

    DEBUG("pidIn_: %f", pidIn_);

    // handle PID auto-tune logic
    if (status_.pidAutoTuneBusy) {
      pidOut_ = tuner_.tunePID(pidIn_, micros());

      if (tuner_.isFinished()) {
        stopPID_AutoTune();

        INFO("auto tune done!");
        INFO(
          "Kp: %d, Ki: %d, Kd: %d",
          (uint16_t)(tuner_.getKp() * 100),
          (uint16_t)(tuner_.getKi() * 100),
          (uint16_t)(tuner_.getKd() * 100));
      }
    }

    // negative PWM means we need to close throttle; results in inverse
    // motor polarity in H-Bridge driver use cases, or just undriven
    // motor otherwise (relies on throttle body return spring to close)
    motorOut_ = pidOut_;
  }
  else
  {
    tpsTarget_ = 0;
    motorOut_ = 0;
    motorCurrent_mA_ = 0;
  }

  // make user ADC conversions are running correctly
  if (newCycle)
  {
    static uint16_t prevADC_Cycles = 0;
    const uint16_t deltaCycles = adc::conversionCycles - prevADC_Cycles;
    prevADC_Cycles = adc::conversionCycles;
    if (deltaCycles == 0)
    {
      status_.adcStalled = 1;
      disableMotor();
    }
  }

  // update motor driver fault status
  // The MC33887 fault status pin is active low. It will assert the fault status
  // pin if the driver is in the disabled state. Since we sometimes disable the
  // motor driver on purpose, I'm checking that we intentionally have the motor
  // in the enabled state before flagging a fault.
  if (status_.motorEnabled && digitalRead(driverPinFS_) == 0)
  {
    status_.motorDriverFault = 1;
  }

  // drive motor outputs
#ifdef SUPPORT_H_BRIDGE
  // handle h-bridge polarity inversion logic
  if (motorOut_ > 0) {
    analogWrite(driverPinP_, motorOut_);
    analogWrite(driverPinN_, 0);
    // setup motor current measurement on OC0B match ISR (motor P is on pin 5 - OC0B)
    adc::driverFB.tMode = adc::TriggerMode_E::eTM_ISR_Tmr0_OCB;
  } else if (motorOut_ < 0) {
    analogWrite(driverPinP_, 0);
    analogWrite(driverPinN_, motorOut_ * -1);// * -1 to write PWM magnitude only
    // setup motor current measurement on OC0A match ISR (motor N is on pin 6 - OC0A)
    adc::driverFB.tMode = adc::TriggerMode_E::eTM_ISR_Tmr0_OCA;
  } else {
    analogWrite(driverPinP_, 0);
    analogWrite(driverPinN_, 0);
  }
#else
  // no h-bridge means we can only drive the motor 1 way
  analogWrite(driverPinP_, motorOut_);
  analogWrite(driverPinN_, 0);
  // setup motor current measurement on OC0B match ISR (motor P is on pin 5 - OC0B)
  adc::driverFB.tMode = adc::TriggerMode_E::eTM_ISR_Tmr0_OCB;
#endif

  // request driver current ADC measurement once a PID cycle
  adc::driverFB.needsMeasure = newCycle;
}

void
Throttle::doMotorCurrent()
{
  driverFB_ = adc::driverFB.value;

  // feedback pin drives 1/375th the current to ground through 100ohm resistor.
  // V_fb = ADC * 5.0v / 1023
  // V_fb = I * R = I_fb * 100ohm
  // I_fb = I_m * 1/375
  //  V_fb -> voltage see over 100ohm resistor
  //  I_fb -> current out of driver's feedback pin (proportional to I_m)
  //  I_m  -> current through motor
  // solve for 'I_m' using the above equations:
  //  I_m = ADC * (5/1023) * (375/100)
  //  I_m = ADC * 0.018328 <- in amps
  motorCurrent_mA_ = driverFB_ * 18.328;
}
