hankedan000/EThrottle/(commit log)

2022-06-27 Initial commit of throttle code
2022-08-28 Moved throttle PID code in doThrottle()
2022-08-29 no longer uses floating point math for pps interpolation
    [EThrottle.ino]
2022-08-29 Adds support for directional motor control (h-bridge)
2023-01-30 Adds initial PCB design
    [msq-dbw.eprj]
2023-01-30 Adds MC33887 motor driver to the schematic
    [msq-dbw.eprj]
2023-03-10 Adds CAN circuit to schematic
    [msq-dbw.eprj]
2023-03-10 Creates Throttle class to wrap all DBW throttle logic
2023-03-10 Fixes some range issues
    [Throttle.cpp, Throttle.h]
2023-03-10 new default PID coeffs
2023-03-11 Adds board layout photos
2023-03-11 Initial PCB component layout
    [msq-dbw.eprj]
2023-03-15 More board work
    [msq-dbw.eprj]
2023-03-15 Manually routed some things
    [msq-dbw.eprj]
2023-03-17 Nearly final board design
    [msq-dbw.eprj]
2023-03-18 Screate board with SOIC version of MCP2515
    [msq-dbw.eprj, msq_ethrottle_soic.eprj, msq_ethrottle_tssop.eprj]
2023-03-18 PCB v1.0 (ordered through JLC PCB)
    [msq_ethrottle_soic.eprj]
2023-03-18 Fixes current feedback resistor value (10K -> 100)
    [msq_ethrottle_soic.eprj]
2023-04-01 Fixes wheelspeed resistor values. Started wiring harness design.
    [msq_ethrottle_soic.eprj, msq_ethrottle_tssop.eprj]
2023-04-01 Updates to run with IO for PCB design
2023-04-08 Stores PID coefficients in flash
2023-04-09 Can set PID coefficients from Tuner Studio
2023-04-09 Adds motor current feedback logic
2023-04-10 Uses higher PWM frequency
2023-04-11 Refactor Throttle class to be an extern
2023-04-13 Can load & tune sensor range calibration values
2023-04-19 Sets tps_ to 0% when TPS safety check fails
    [Throttle.cpp]
2023-04-20 Adds ability to enable/disable throttle from UART
2023-04-20 Can process UART commands that are written via CAN
    This allows for tuner studio to enable/disable the throttle
2023-04-22 Adds motor driver fault monitoring. Adds fault clearing capabilities.
2023-04-22 Driver fault status is sticky and only asserted when motor is enabled
2023-04-22 Initial rewrite to support scheduled ADC conversions
2023-04-22 Schedules motor current reading at peak current draw (PWM pulse end)
2023-04-22 Fixes motor current measurement jitter (also requires MegaCAN commit 658d9c4)
    [can.cpp]
2023-04-23 Adds oscope images of motor current feedback measurement
2023-04-23 Updated current feedback documentation
2023-04-24 Fixes garbage ADC readings causing faults at startup
    [adc_ctrl.cpp, adc_ctrl.h]
2023-05-28 shrink board width by 1.1mm to avoid interference with enclosure
    [msq_ethrottle_soic.eprj, msq_ethrottle_tssop.eprj]
2023-05-28 README updates related to PCB design and changes
2023-05-29 Adds raw sensor values to logging table
2023-06-03 Updates for MegaCAN flipped rev/sig fix
    [can.cpp]
2023-06-03 Adds watchdog reset logic. Adds MCUSR reporting.
    [EThrottle.ino, tables.h]
2023-06-03 Adds soft reset UART command. Had to move defines to config.h
    [EThrottle.ino, config.h]
2023-06-03 Fixes MCUSR acquisiton from mcp-can-boot bootloader.
    for what ever reason, I could not get the original approach to work. It seemed like avrgcc wasn't calling my function at all even though it was marked with the init0 section. Add this bit of assembly to the setup() routine recovers the MCUSR value from the r2 register just fine though.
    [EThrottle.ino]
2023-09-21 Adds short/long term fault filters
    Goals:
    * a way to ignore sensor noise (not ideal)
    * automates clearing fault conditions (waits for period of stable sensor readings)
    [FaultFilter.h, Throttle.cpp, Throttle.h, tables.h]
2023-09-21 Adds ADC status gauges
    Adds more ADC debug gauges
2023-09-21 Removes UART cmd processing feature (saves some flash and RAM)
2023-09-21 build fixes after MegaCAN lib reduced reference arg usage
    [can.cpp, can.h]
2023-09-21 Adds ADC stall detection
    [Throttle.cpp, Throttle.h]
2023-09-21 Renamed avr dir to arduino
2023-09-21 Switch to git submodules for Arduino library dependencies
